Baffmer/HRWizard/README.md

# HRWizard
Projekt "HRWizard" für das Modul "Eingebettete Systeme"
