Baffmer/HRWizard/PCB/BOM.xlsx

Name | MPN | Placed | References | Value | Quantity PCB | Quantity | Price Per Piece | Price
Seeed Studio Zubehör Grove - Universal 4 pin connector | 110990030 | yes | Grove Stecker | Grove_Connector | 3 | 7 | 0.13 € | 2.67 €
Female Pin Header für Sensoren | M20-7820842 | yes | Sensorplatine | Conn_01x08_Female | 3 | 2 | 0.89 € | 5.33 €
Pufferkondensator für LEDs | CC0805KRX7R9BB104 | yes | C1, C2, C3, C4, C6, C7, C8, C11, C12, C14, C15, C16, C17, C18, C20, C21, C22, C23, C24, C25 | 0805 - 100n | 3 | 20 | 0.03 € | 1.98 €
RGB LEDs | COM-16346 | yes | D1, D2, D3, D4, D5, D6, D7, D8, D9, D10, D11, D12, D13, D14, D15, D16, D17, D18, D19, D20, D21, D22, D23, D24, D25 | WS2812B | 3 | 25 | 0.44 € | 33.03 €
Vorwiderstand Power LED | CRCW0805330RFKTA | yes | R9 | 0805 - 330R | 3 | 1 | 0.11 € | 0.32 €
Power LED orange | HSMD-C170 | yes | D1 | LED_Small | 3 | 1 | 0.22 € | 0.66 €
Raspberry Pi Pico | DEV-17829 | yes | U1 | Pico | 3 | 1 | 4.29 € | 12.87 €
Tactical Switch | TS04-66-95-BK-260-SMT | yes | SW1, SW2, SW3, SW4, SW5, SW6, SW7 | SW_Push | 3 | 7 | 0.15 € | 3.09 €
Seeed Grove Cable | 114991495 |  |  |  | 1 | 20 | 0.47 € | 9.40 €
 |  |  |  |  |  |  | Gesamt: | 69.35 €
