Baffmer/HRWizard/Praktikumsanleitungen/Praktikumsanleitung_Temperatursensor_HTS221.docx

Anleitung für ein Praktikum mit dem HRWizard Development Board (Raspberry Pi Pico) und dem Temperatursensor HTS221 (über I²C)

Nikolaj Pauly

Céline Gutt

Shuhrat Okhunov

Praktikums-beispiel HRWizard

Temperatursensor HTS221

# Einleitung

Im Bereich der Mikrocontroller ist die Temperaturerfassung oft eines der ersten Beispiele. Hier soll der Mikrocontroller Raspberry Pi Pico (https://www.berrybase.de/neu/raspberry-pi-pico-rp2040-mikrocontroller-board) verwendet werden, welcher auf dem HRWizard Development Board zur Verfügung steht. Auf diesem Board gibt es einen I²C (https://de.wikipedia.org/wiki/I%C2%B2C) Anschluss, an welchem eine Sensorplatine angeschlossen werden kann. Diese Sensorplatine dient als Adapter Platine für eine Vielzahl von Sensorplatinen der Firma Adafruit von der Bauform STEMMA QT (https://www.adafruit.com/product/4535). Der hier verwendete Temperatursensor ist der HTS221 (https://www.google.com/url?rct=j&q=&esrc=s&cd=&cad=rja&uact=8) von ST.

Als Aktoren könnten folgende Elemente verwendet werden:

- Die LED-Platine des HRWizzard mit den WS2812 (https://cdn-shop.adafruit.com/datasheets/WS2812.pdf) LEDs
- Die Debugging Ausgabe

Das Besondere am Raspberry Pi Pico ist, dass dieser mit der Programmiersprache Micro Python programmiert werden kann. Im Gegensatz zur Programmiersprache C/C++ (wie z.B. bei den Arduino Mikrocontrollern) ist die reduzierte Semantik und vereinfachte Syntax, da es sich bei Python um eine Skriptsprache handelt. Dies reduziert die Einstiegshürde erheblich und macht den Code leichter verständlich.

# Ziel des Praktikums

Im Fokus dieses Praktikums steht das Bussystem I²C. Für den Temperatursensor ist bereits ein Python Code vorhanden, welcher dazu verwendet werden kann, von diesem die Temperatur (bzw. die Luftfeuchtigkeit) über den I²C Bus auszulesen.

Wenn dies erstmal funktioniert, steht es dem Praktikanten frei daraus eine sinnvolle Ausgabe für die LED-Platine zu kreieren. Für diese LED-Platine steht ebenfalls ein Python-Code zur Verfügung, welcher als Grundlage verwendet werden kann.

# Grundkenntnisse

Empfohlen werden folgende Grundkenntnisse:

- Erstellen von Funktionen in Python
- Einbinden von externen Python Dateien
- Grundlagen I²C Bus
- Einfache Programmstrukturen, wie:
  - If/elif/else
  - For/while Schleifen
  - Variablen und deren Manipulationen

# Anleitung

1. Verbinden Sie die Hauptplatine, die Sensorplatine sowie die LED-Platine zusammen. Verwenden Sie dafür die Vierfachsteckverbinder. Achten Sie darauf, dass Sie die richtigen Buchsen für die jeweiligen Platinen verwenden (auf der Hauptplatine die Beschriftung beachten „LED“ und „I2C“).
2. Verbinden Sie die Hauptplatine mit dem PC. Verwenden Sie dafür ein Micro-USB Kabel. Nun sollte die „PWRon“ LED leuchten.
3. Starten Sie die IDE Thonny und öffnen Sie die folgenden Dateien:
  a. HRWizzardLED.py
  b. HRWizzardI2C.py
  c. HRWizzardSensorHTS221.py
4. Erstellen Sie eine neue Datei: main.py
5. Speichern Sie die Dateien auf den Raspberry Pi Pico, indem Sie unter Datei → Speichern unter als Speicherort den Pico auswählen

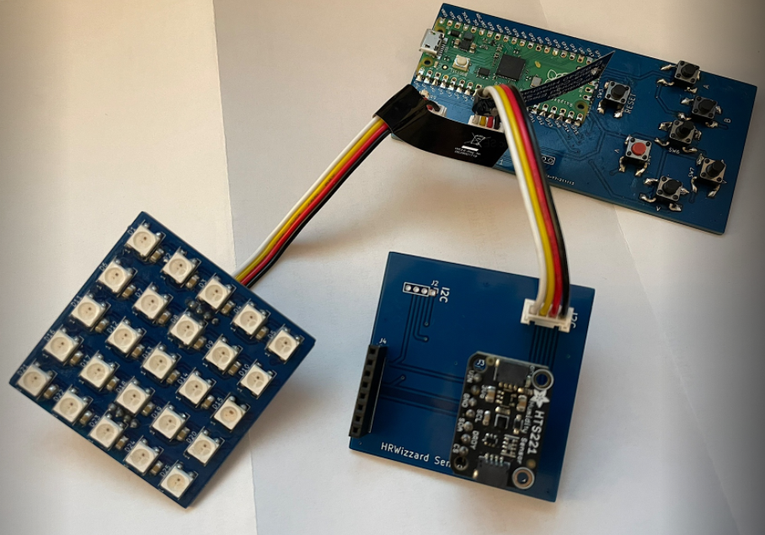
[picture p1: figure]

Abbildung 1: Zusammengesteckte Platinen

Die main.py könnte wie folgt aussehen:

import HRWizzardButtons

import HRWizzardLED

import HRWizzardI2C

import HRWizzardSensorHTS221

import machine, time

HRWizzardButtons.initButtons()

print("Welcome to HRWizzard!")

if HRWizzardSensorHTS221.checkHTS221isPresent() == True:

HRWizzardSensorHTS221.initHTS221()

#HRWizzardSensorHTS221.getTempFromHTS221()

while True:

#HRWizzardLED.testLED()

temp = HRWizzardSensorHTS221.getTempFromHTS221()

HRWizzardLED.setColorToAllLED(

HRWizzardSensorHTS221.switchTempColor(temp))

time.sleep_ms(100)

# Erweiterungen

- Es könnte eine zweite LED- Platine verwendet werden, um zweistellige Zahlen (also die Temperatur) darstellen zu können.
- Es könnte bei der LED-Platine, die Hälfte der LED-Fläche für die Luftfeuchtigkeit verwendet werden.
