Baffmer/HRWizard/PCB/Sensor-Platine/Projekt1.kicad_pcb

## KiCad design PCB/Sensor-Platine/Projekt1.kicad_pcb (2022-04-24)

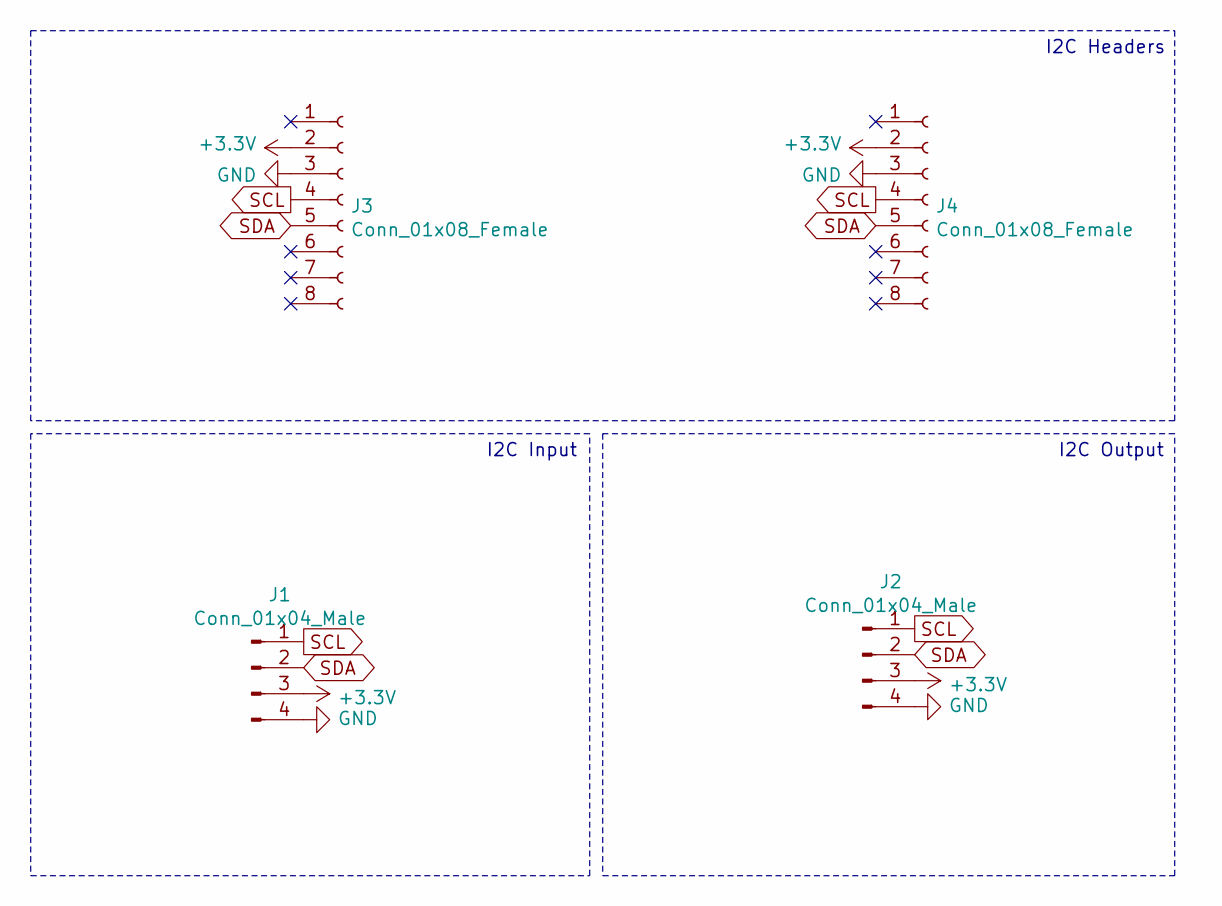
[picture p2: schematic Projekt1.sch]

Parts:
J1, J2: Conn_01x04_Male; PinHeader_1x04_P2.00mm_Vertical
J3, J4: Conn_01x08_Female; PinHeader_1x08_P2.54mm_Vertical

Connections:
+3V3: J1.3, J2.3, J3.2, J4.2
GND: J1.4, J2.4, J3.3, J4.3
SCL: J1.1, J2.1, J3.4, J4.4
SDA: J1.2, J2.2, J3.5, J4.5

Notes on the sheet:
I2C Input
I2C Output
I2C Headers

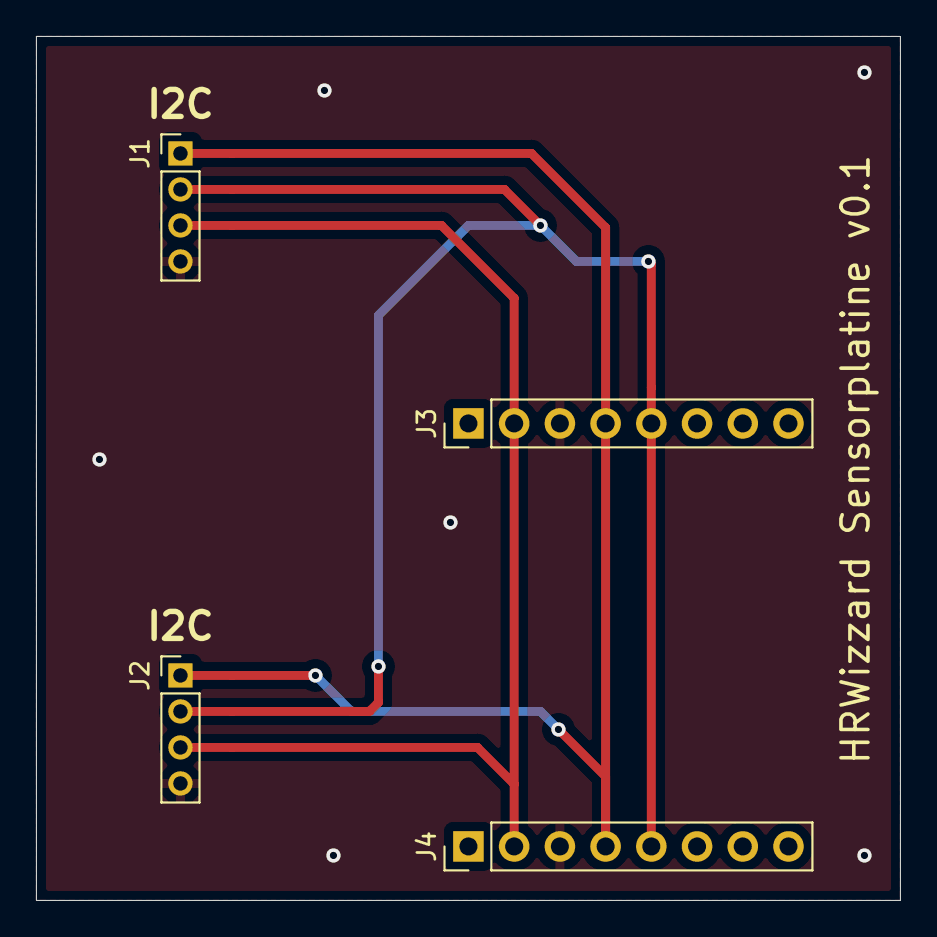
[picture p3: board PCB/Sensor-Platine/Projekt1.kicad_pcb from above]

Board: 2 copper layers, 48.0 x 48.0 mm, 4 parts (0 on the bottom side), 4 nets.
