Baffmer/HRWizard/PCB/HRWizzard_Test/HRWizzard.kicad_pcb

## KiCad design PCB/HRWizzard_Test/HRWizzard.kicad_pcb (2022-04-24)

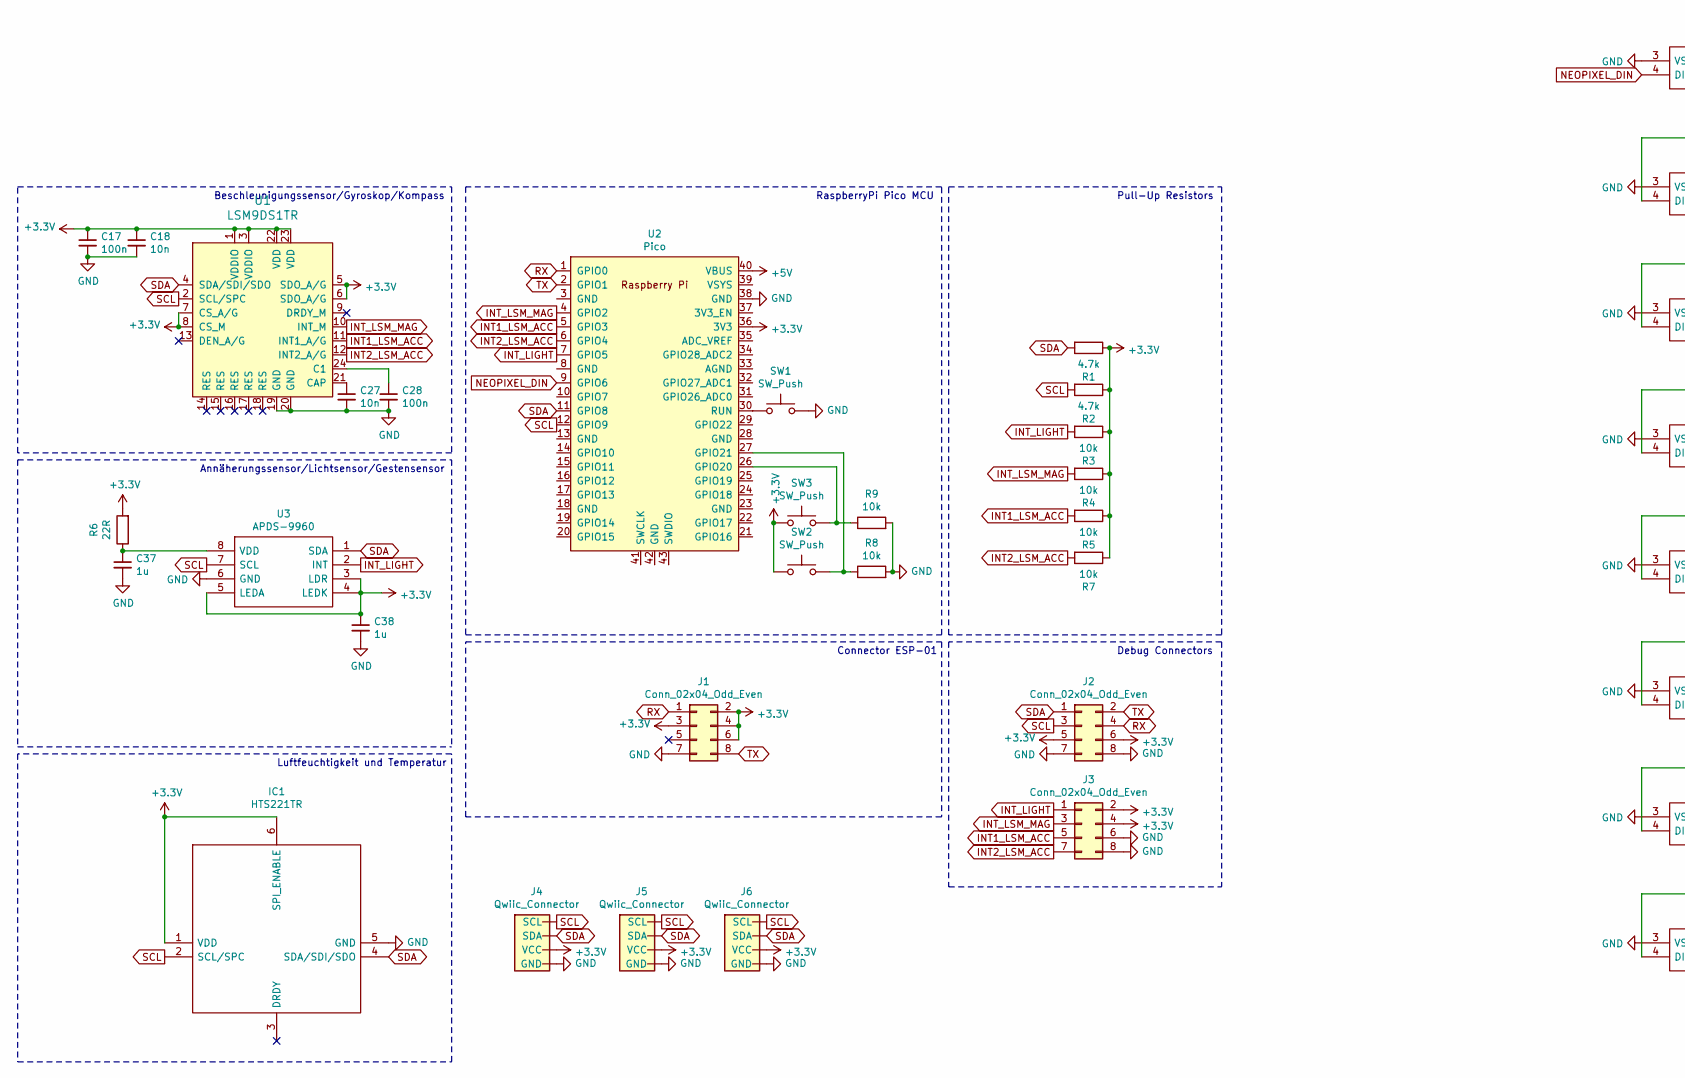
[picture p7: schematic HRWizzard.sch, part in row 1, column 1]

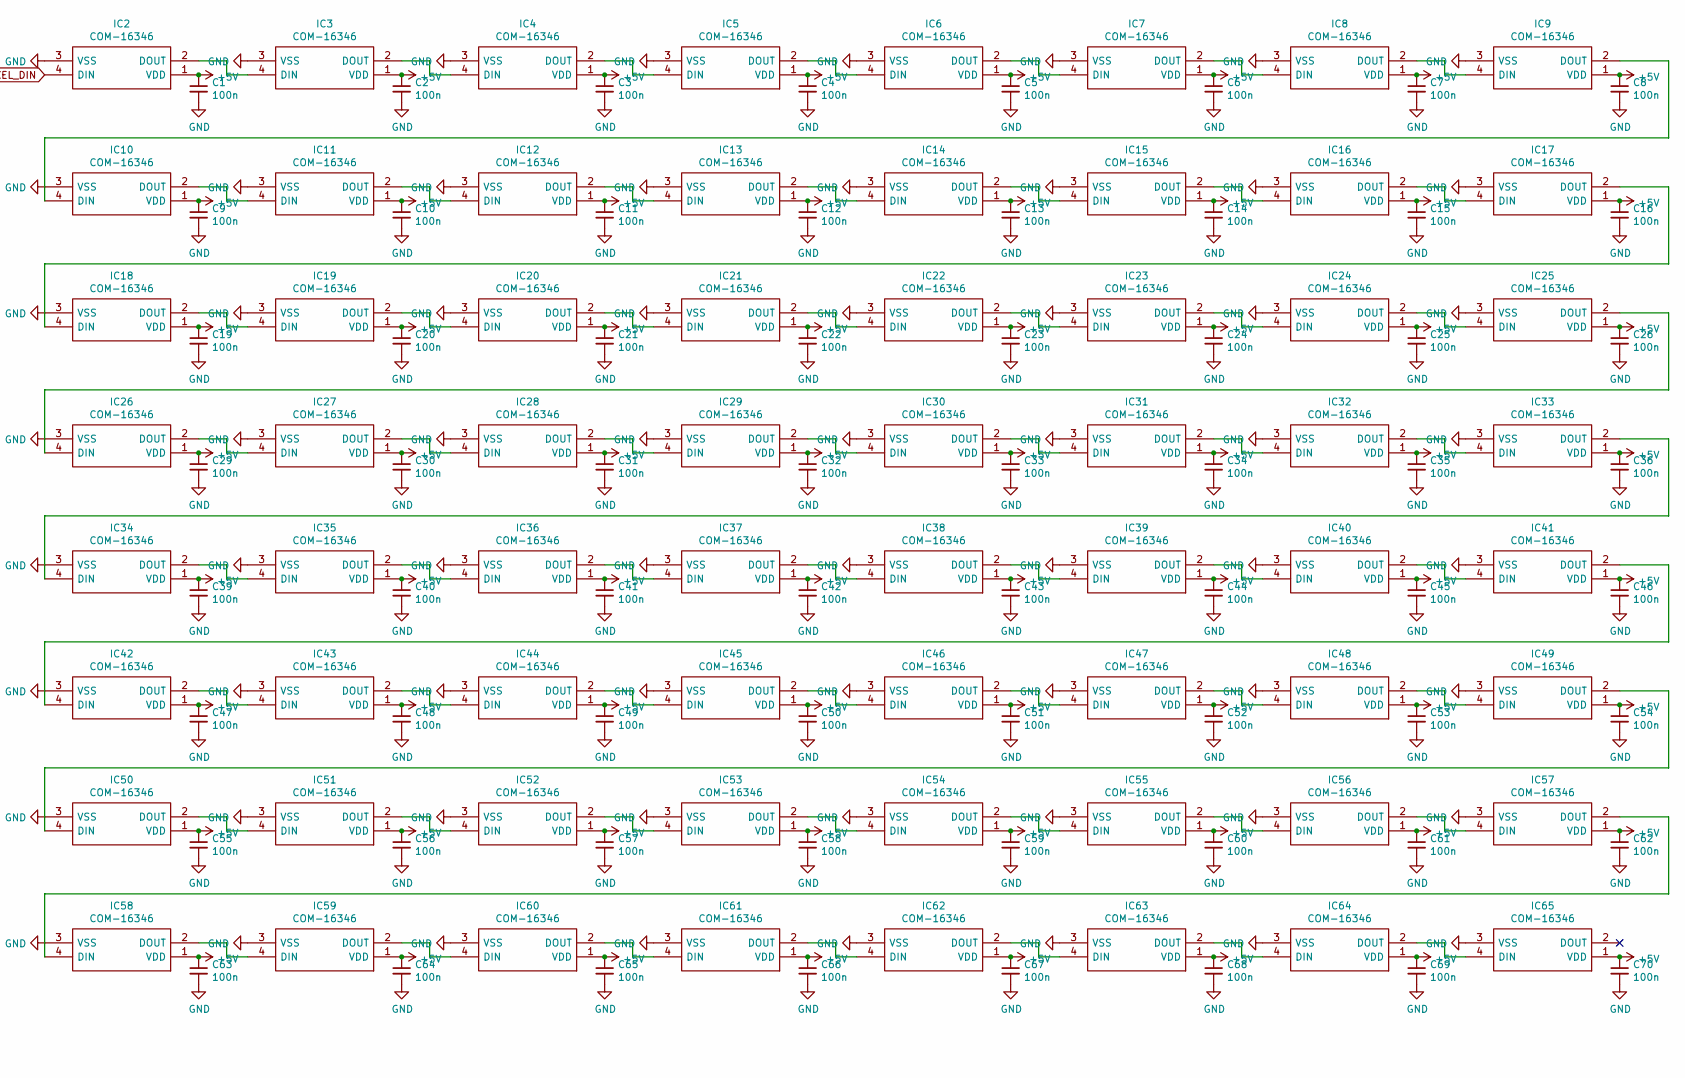
[picture p8: schematic HRWizzard.sch, part in row 1, column 2]

Parts:
C1, C2, C3, C4, C5, C6, C7, C8, C9, C10, C11, C12, C13, C14, C15, C16, C17, C19, C20, C21, C22, C23, C24, C25, C26, C28, C29, C30, C31, C32, C33, C34, C35, C36, C39, C40, C41, C42, C43, C44, C45, C46, C47, C48, C49, C50, C51, C52, C53, C54, C55, C56, C57, C58, C59, C60, C61, C62, C63, C64, C65, C66, C67, C68, C69, C70: 100n; C_0805_2012Metric_Pad1.18x1.45mm_HandSolder
C18, C27: 10n; C_0805_2012Metric_Pad1.18x1.45mm_HandSolder
C37, C38: 1u; C_0805_2012Metric_Pad1.18x1.45mm_HandSolder
IC1: HTS221TR; HLGA-6L; Manufacturer_Part_Number HTS221TR; Mouser Part Number 511-HTS221TR
IC2, IC3, IC4, IC5, IC6, IC7, IC8, IC9, IC10, IC11, IC12, IC13, IC14, IC15, IC16, IC17, IC18, IC19, IC20, IC21, IC22, IC23, IC24, IC25, IC26, IC27, IC28, IC29, IC30, IC31, IC32, IC33, IC34, IC35, IC36, IC37, IC38, IC39, IC40, IC41, IC42, IC43, IC44, IC45, IC46, IC47, IC48, IC49, IC50, IC51, IC52, IC53, IC54, IC55, IC56, IC57, IC58, IC59, IC60, IC61, IC62, IC63, IC64, IC65: COM-16346; COM16346; Manufacturer_Part_Number COM-16346; Mouser Part Number 474-COM-16346
J1, J2, J3: Conn_02x04_Odd_Even; PinHeader_2x04_P2.54mm_Vertical
J4, J5, J6: Qwiic_Connector; JST_GH_SM04B-GHS-TB_1x04-1MP_P1.25mm_Horizontal
R1, R2: 4.7k; R_0805_2012Metric_Pad1.20x1.40mm_HandSolder
R3, R4, R5, R7, R8, R9: 10k; R_0805_2012Metric_Pad1.20x1.40mm_HandSolder
R6: 22R; R_0805_2012Metric_Pad1.20x1.40mm_HandSolder
SW1, SW2, SW3: SW_Push; Switch_Tactile_SMD_6x6mm
U1: LSM9DS1TR; LGA-24_3x3.5mm_LSM9DS1; MPN LSM9DS1TR; Digi-Key_PN 497-14946-1-ND
U2: Pico; RPi_Pico_SMD_TH
U3: APDS-9960; APDS-9950; Manufacturer_Part_Number APDS-9960; Mouser Part Number 630-APDS-9960

Connections:
+3V3: C17.1, C18.1, C38.1, IC1.1 (VDD), IC1.6 (SPI_ENABLE), J1.2, J1.3, J1.4, J1.6, J2.5, J2.6, J3.2, J3.4, J4.2 (VCC), J5.2 (VCC), J6.2 (VCC), R1.1, R2.1, R3.1, R4.1, R5.1, R6.2, R7.1, SW2.1, SW3.1, U1.1 (VDDIO), U1.3 (VDDIO), U1.5 (SDO_A/G), U1.6 (SDO_A/G), U1.7 (CS_A/G), U1.8 (CS_M), U1.22 (VDD), U1.23 (VDD), U2.36 (3V3), U3.3 (LDR), U3.4 (LEDK), U3.5 (LEDA)
+5V: C1.1, C2.1, C3.1, C4.1, C5.1, C6.1, C7.1, C8.1, C9.1, C10.1, C11.1, C12.1, C13.1, C14.1, C15.1, C16.1, C19.1, C20.1, C21.1, C22.1, C23.1, C24.1, C25.1, C26.1, C29.1, C30.1, C31.1, C32.1, C33.1, C34.1, C35.1, C36.1, C39.1, C40.1, C41.1, C42.1, C43.1, C44.1, C45.1, C46.1, C47.1, C48.1, C49.1, C50.1, C51.1, C52.1, C53.1, C54.1, C55.1, C56.1, C57.1, C58.1, C59.1, C60.1, C61.1, C62.1, C63.1, C64.1, C65.1, C66.1, C67.1, C68.1, C69.1, C70.1, IC2.1 (VDD), IC3.1 (VDD), IC4.1 (VDD), IC5.1 (VDD), IC6.1 (VDD), IC7.1 (VDD), IC8.1 (VDD), IC9.1 (VDD), IC10.1 (VDD), IC11.1 (VDD), IC12.1 (VDD), IC13.1 (VDD), IC14.1 (VDD), IC15.1 (VDD), IC16.1 (VDD), IC17.1 (VDD), IC18.1 (VDD), IC19.1 (VDD), IC20.1 (VDD), IC21.1 (VDD), IC22.1 (VDD), IC23.1 (VDD), IC24.1 (VDD), IC25.1 (VDD), IC26.1 (VDD), IC27.1 (VDD), IC28.1 (VDD), IC29.1 (VDD), IC30.1 (VDD), IC31.1 (VDD), IC32.1 (VDD), IC33.1 (VDD), IC34.1 (VDD), IC35.1 (VDD), IC36.1 (VDD), IC37.1 (VDD), IC38.1 (VDD), IC39.1 (VDD), IC40.1 (VDD), IC41.1 (VDD), IC42.1 (VDD), IC43.1 (VDD), IC44.1 (VDD), IC45.1 (VDD), IC46.1 (VDD), IC47.1 (VDD), IC48.1 (VDD), IC49.1 (VDD), IC50.1 (VDD), IC51.1 (VDD), IC52.1 (VDD), IC53.1 (VDD), IC54.1 (VDD), IC55.1 (VDD), IC56.1 (VDD), IC57.1 (VDD), IC58.1 (VDD), IC59.1 (VDD), IC60.1 (VDD), IC61.1 (VDD), IC62.1 (VDD), IC63.1 (VDD), IC64.1 (VDD), IC65.1 (VDD), U2.40 (VBUS)
INT1_LSM_ACC: J3.5, R5.2, U1.11 (INT1_A/G), U2.5 (GPIO3)
INT2_LSM_ACC: J3.7, R7.2, U1.12 (INT2_A/G), U2.6 (GPIO4)
INT_LIGHT: J3.1, R3.2, U2.7 (GPIO5), U3.2 (INT)
INT_LSM_MAG: J3.3, R4.2, U1.10 (INT_M), U2.4 (GPIO2)
NEOPIXEL_DIN: IC2.4 (DIN), U2.9 (GPIO6)
unnamed: C27.1, U1.21 (CAP)
unnamed: C28.1, U1.24 (C1)
unnamed: C37.1, R6.1, U3.8 (VDD)
unnamed: IC2.2 (DOUT), IC3.4 (DIN)
unnamed: IC3.2 (DOUT), IC4.4 (DIN)
unnamed: IC4.2 (DOUT), IC5.4 (DIN)
unnamed: IC5.2 (DOUT), IC6.4 (DIN)
unnamed: IC6.2 (DOUT), IC7.4 (DIN)
unnamed: IC7.2 (DOUT), IC8.4 (DIN)
unnamed: IC8.2 (DOUT), IC9.4 (DIN)
unnamed: IC10.2 (DOUT), IC11.4 (DIN)
unnamed: IC11.2 (DOUT), IC12.4 (DIN)
unnamed: IC12.2 (DOUT), IC13.4 (DIN)
unnamed: IC13.2 (DOUT), IC14.4 (DIN)
unnamed: IC14.2 (DOUT), IC15.4 (DIN)
unnamed: IC15.2 (DOUT), IC16.4 (DIN)
unnamed: IC16.2 (DOUT), IC17.4 (DIN)
unnamed: IC18.2 (DOUT), IC19.4 (DIN)
unnamed: IC19.2 (DOUT), IC20.4 (DIN)
unnamed: IC20.2 (DOUT), IC21.4 (DIN)
unnamed: IC21.2 (DOUT), IC22.4 (DIN)
unnamed: IC22.2 (DOUT), IC23.4 (DIN)
unnamed: IC23.2 (DOUT), IC24.4 (DIN)
unnamed: IC24.2 (DOUT), IC25.4 (DIN)
unnamed: IC26.2 (DOUT), IC27.4 (DIN)
unnamed: IC27.2 (DOUT), IC28.4 (DIN)
unnamed: IC28.2 (DOUT), IC29.4 (DIN)
unnamed: IC29.2 (DOUT), IC30.4 (DIN)
unnamed: IC30.2 (DOUT), IC31.4 (DIN)
unnamed: IC31.2 (DOUT), IC32.4 (DIN)
unnamed: IC32.2 (DOUT), IC33.4 (DIN)
unnamed: IC34.2 (DOUT), IC35.4 (DIN)
unnamed: IC35.2 (DOUT), IC36.4 (DIN)
unnamed: IC36.2 (DOUT), IC37.4 (DIN)
unnamed: IC37.2 (DOUT), IC38.4 (DIN)
unnamed: IC38.2 (DOUT), IC39.4 (DIN)
unnamed: IC39.2 (DOUT), IC40.4 (DIN)
unnamed: IC40.2 (DOUT), IC41.4 (DIN)
unnamed: IC42.2 (DOUT), IC43.4 (DIN)
unnamed: IC43.2 (DOUT), IC44.4 (DIN)
unnamed: IC44.2 (DOUT), IC45.4 (DIN)
unnamed: IC45.2 (DOUT), IC46.4 (DIN)
unnamed: IC46.2 (DOUT), IC47.4 (DIN)
unnamed: IC47.2 (DOUT), IC48.4 (DIN)
unnamed: IC48.2 (DOUT), IC49.4 (DIN)
unnamed: IC50.2 (DOUT), IC51.4 (DIN)
unnamed: IC51.2 (DOUT), IC52.4 (DIN)
unnamed: IC52.2 (DOUT), IC53.4 (DIN)
unnamed: IC53.2 (DOUT), IC54.4 (DIN)
unnamed: IC54.2 (DOUT), IC55.4 (DIN)
unnamed: IC55.2 (DOUT), IC56.4 (DIN)
unnamed: IC56.2 (DOUT), IC57.4 (DIN)
unnamed: IC58.2 (DOUT), IC59.4 (DIN)
unnamed: IC59.2 (DOUT), IC60.4 (DIN)
unnamed: IC60.2 (DOUT), IC61.4 (DIN)
unnamed: IC61.2 (DOUT), IC62.4 (DIN)
unnamed: IC62.2 (DOUT), IC63.4 (DIN)
unnamed: IC63.2 (DOUT), IC64.4 (DIN)
unnamed: IC64.2 (DOUT), IC65.4 (DIN)
unnamed: R8.1, SW2.2, U2.27 (GPIO21)
unnamed: R9.1, SW3.2, U2.26 (GPIO20)
unnamed: SW1.1, U2.30 (RUN)
RX: J1.1, J2.4, U2.1 (GPIO0)
SCL: IC1.2 (SCL/SPC), J2.3, J4.4 (SCL), J5.4 (SCL), J6.4 (SCL), R2.2, U1.2 (SCL/SPC), U2.12 (GPIO9), U3.7 (SCL)
SDA: IC1.4 (SDA/SDI/SDO), J2.1, J4.3 (SDA), J5.3 (SDA), J6.3 (SDA), R1.2, U1.4 (SDA/SDI/SDO), U2.11 (GPIO8), U3.1 (SDA)
TX: J1.8, J2.2, U2.2 (GPIO1)

Notes on the sheet:
Annäherungssensor/Lichtsensor/Gestensensor
Beschleunigungssensor/Gyroskop/Kompass
Luftfeuchtigkeit und Temperatur
Pull-Up Resistors
RaspberryPi Pico MCU
Connector ESP-01
Debug Connectors

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
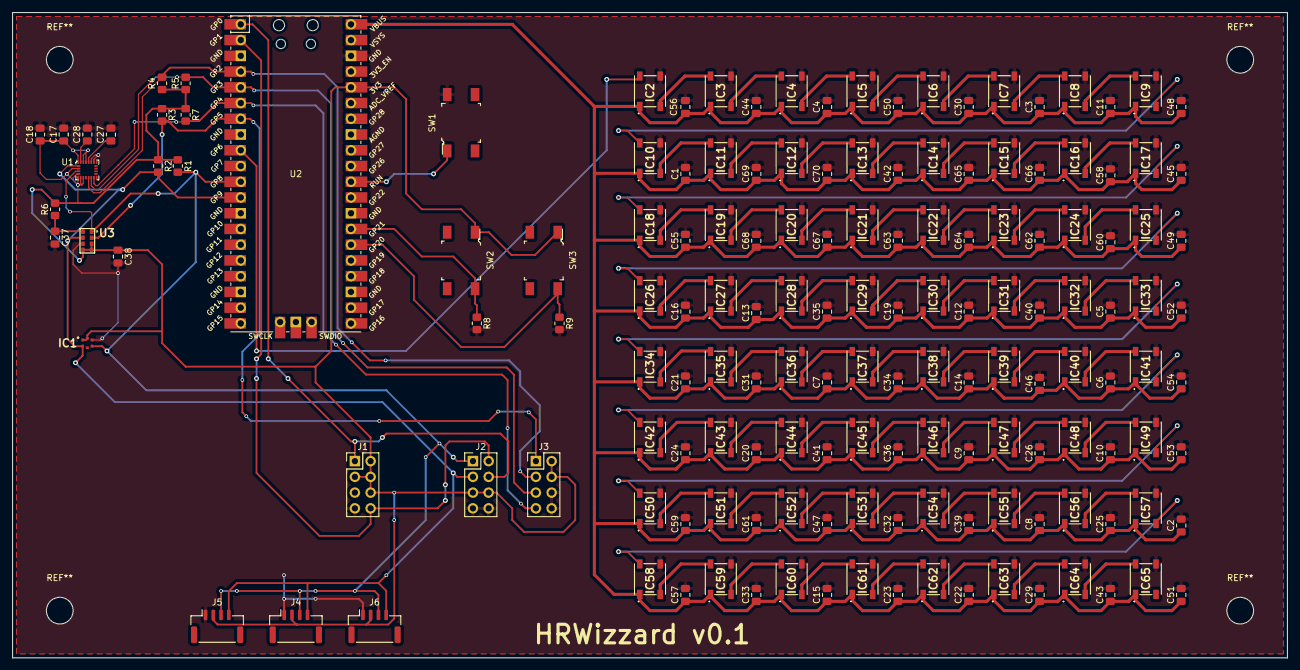
[picture p9: board PCB/HRWizzard_Test/HRWizzard.kicad_pcb from above]

Board: 2 copper layers, 205.7 x 104.1 mm, 156 parts (0 on the bottom side), 81 nets.
