Baffmer/HRWizard/PCB/Hauptplatine/HRWizzard.kicad_pcb

## KiCad design PCB/Hauptplatine/HRWizzard.kicad_pcb (2022-04-24)

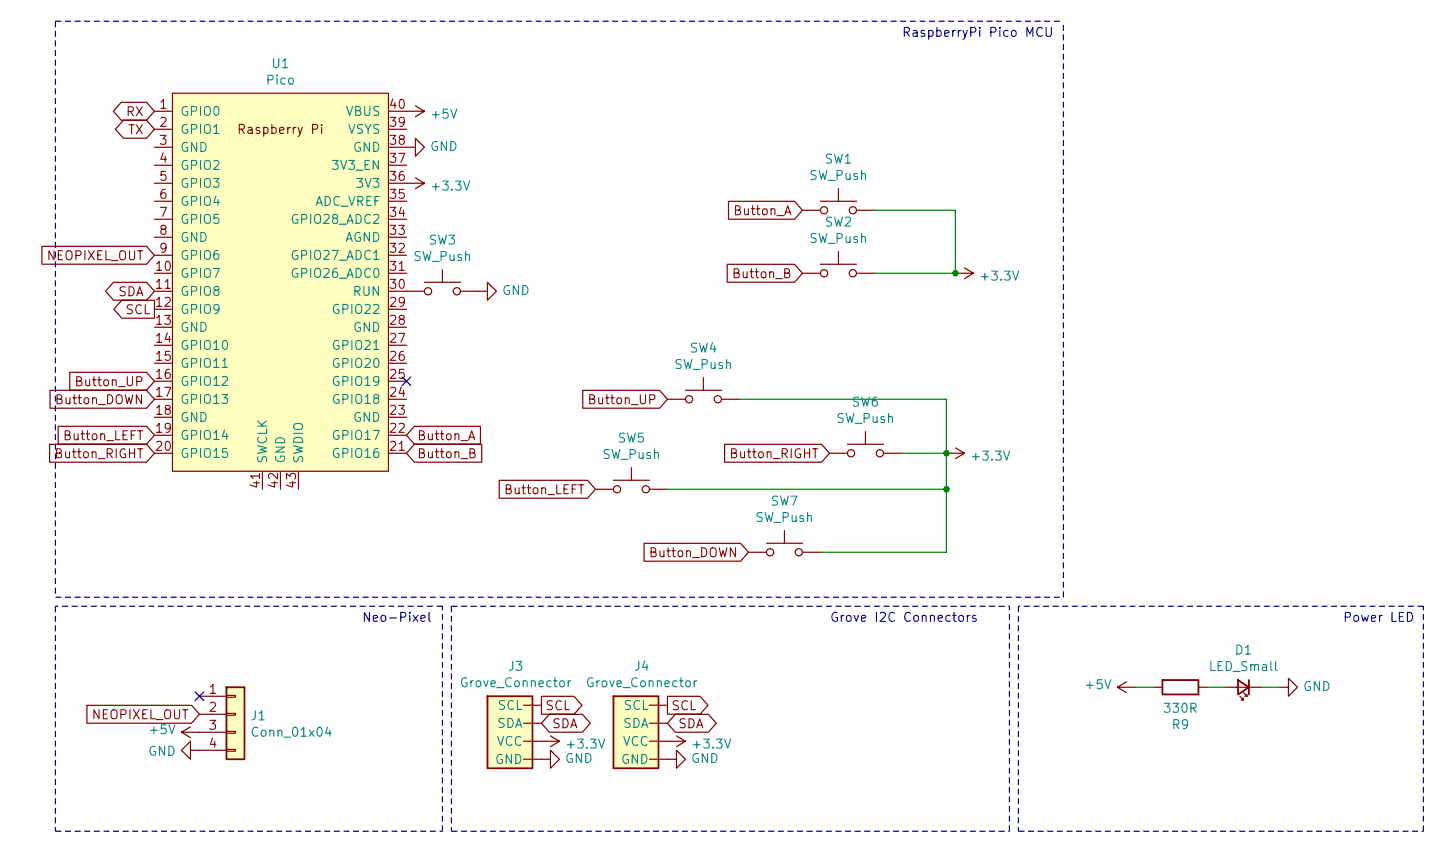
[picture p10: schematic HRWizzard.sch]

Parts:
D1: LED_Small; LED_0805_2012Metric_Pad1.15x1.40mm_HandSolder
J1: Conn_01x04; PinHeader_1x04_P2.00mm_Vertical
J3, J4: Grove_Connector; PinHeader_1x04_P2.00mm_Vertical
R9: 330R; R_0805_2012Metric_Pad1.20x1.40mm_HandSolder
SW1, SW2, SW3, SW4, SW5, SW6, SW7: SW_Push; Switch_Tactile_SMD_6x6mm
U1: Pico; RPi_Pico_SMD_TH

Connections:
+3V3: J3.2 (VCC), J4.2 (VCC), SW1.2, SW2.2, SW4.2, SW5.2, SW6.2, SW7.2, U1.36 (3V3)
+5V: J1.3, R9.2, U1.40 (VBUS)
Button_A: SW1.1, U1.22 (GPIO17)
Button_B: SW2.1, U1.21 (GPIO16)
Button_DOWN: SW7.1, U1.17 (GPIO13)
Button_LEFT: SW5.1, U1.19 (GPIO14)
Button_RIGHT: SW6.1, U1.20 (GPIO15)
Button_UP: SW4.1, U1.16 (GPIO12)
GND: D1.1 (K), J1.4, J3.1 (GND), J4.1 (GND), SW3.2, U1.38 (GND)
NEOPIXEL_OUT: J1.2, U1.9 (GPIO6)
unnamed: D1.2 (A), R9.1
unnamed: SW3.1, U1.30 (RUN)
RX: U1.1 (GPIO0)
SCL: J3.4 (SCL), J4.4 (SCL), U1.12 (GPIO9)
SDA: J3.3 (SDA), J4.3 (SDA), U1.11 (GPIO8)
TX: U1.2 (GPIO1)

Notes on the sheet:
RaspberryPi Pico MCU
Neo-Pixel
Grove I2C Connectors
Power LED

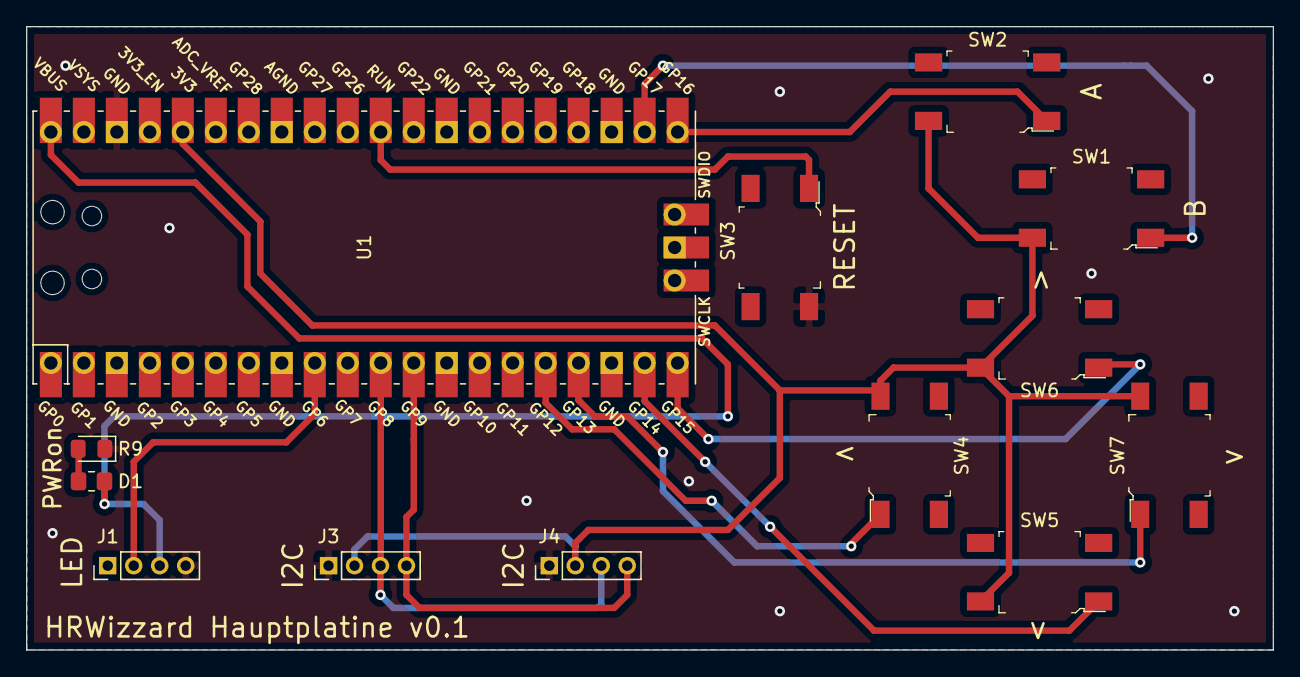
[picture p11: board PCB/Hauptplatine/HRWizzard.kicad_pcb from above]

Board: 2 copper layers, 96.0 x 48.0 mm, 13 parts (0 on the bottom side), 14 nets.
